Dani-Ald/RB-DANI-/Materiales/RB2026.pdf

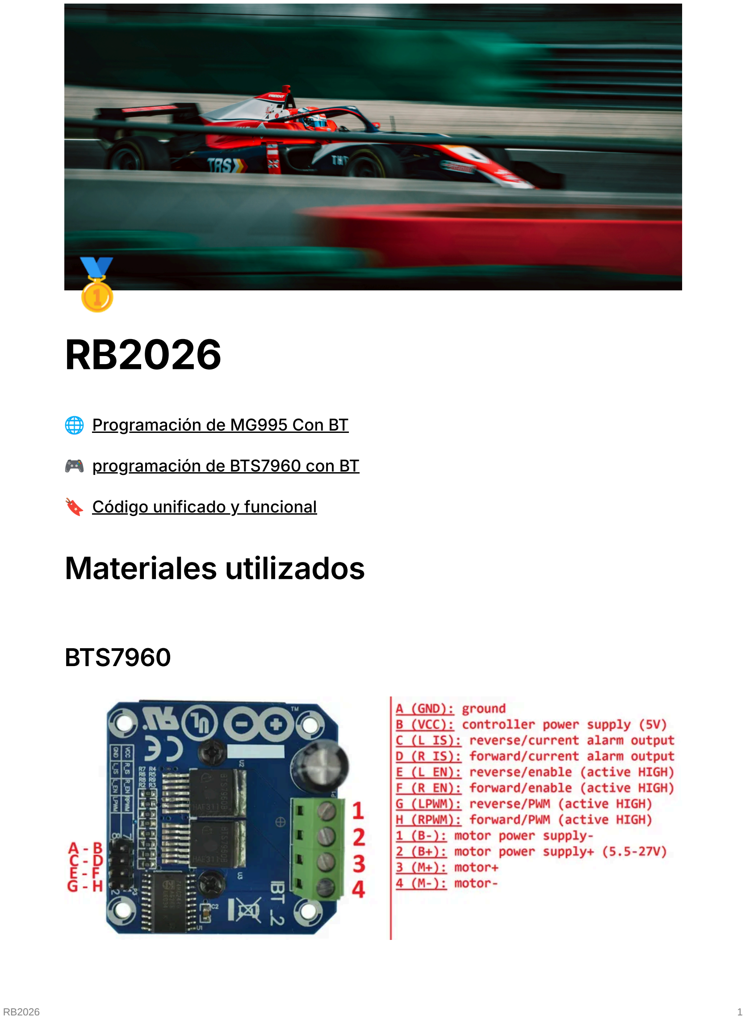
[picture p3: page 1]

🥇
RB2026

🌐 Programación de MG995 Con BT (https://app.notion.com/p/Programaci-n-de-MG995-Con-BT-315e5d4cf5a5803289f7de62a6ee55a4?pvs=21)

🎮 programación de BTS7960 con BT (https://app.notion.com/p/programaci-n-de-BTS7960-con-BT-315e5d4cf5a58018bc2edbbad9db19d2?pvs=21)

🔖 Código unificado y funcional (https://app.notion.com/p/C-digo-unificado-y-funcional-315e5d4cf5a580a5864ffad67fe94708?pvs=21)

# Materiales utilizados

## BTS7960

RB2026 | 1

## RS550 de 6V

## ESP 32

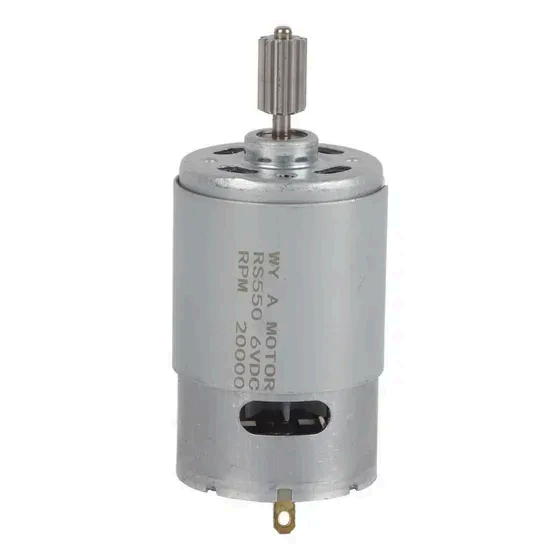
[picture p4: figure]

Durante el desarrollo de este proyecto, se utilizaron diferentes modelos de ESP

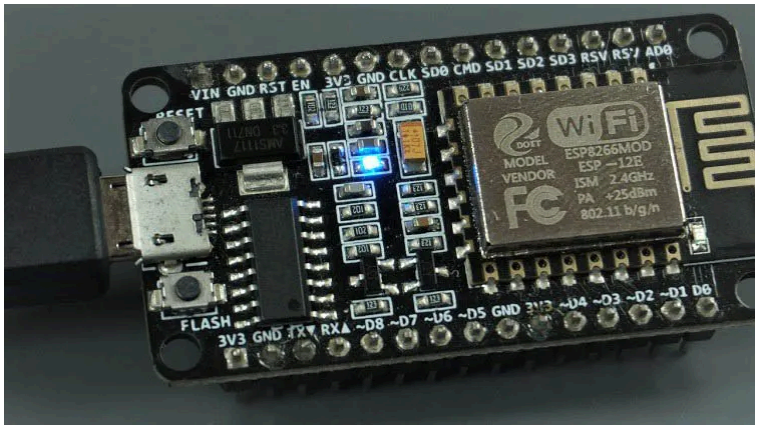
[picture p5: figure]

## Pack de 3 baterias 18650 3.7v 2000mah

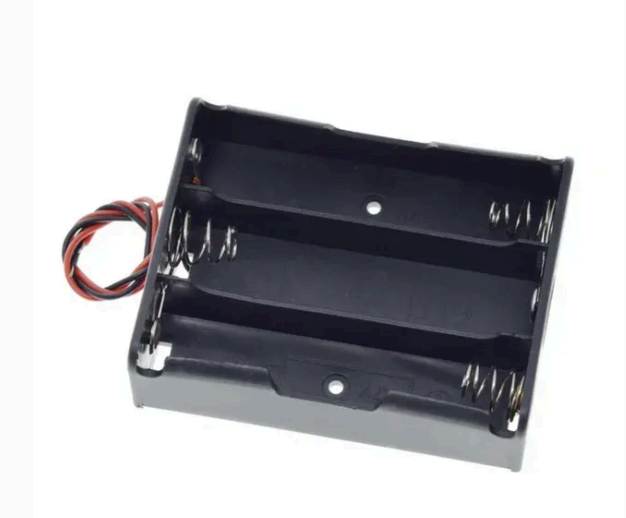
[picture p6: figure]

## Servomotor MG995

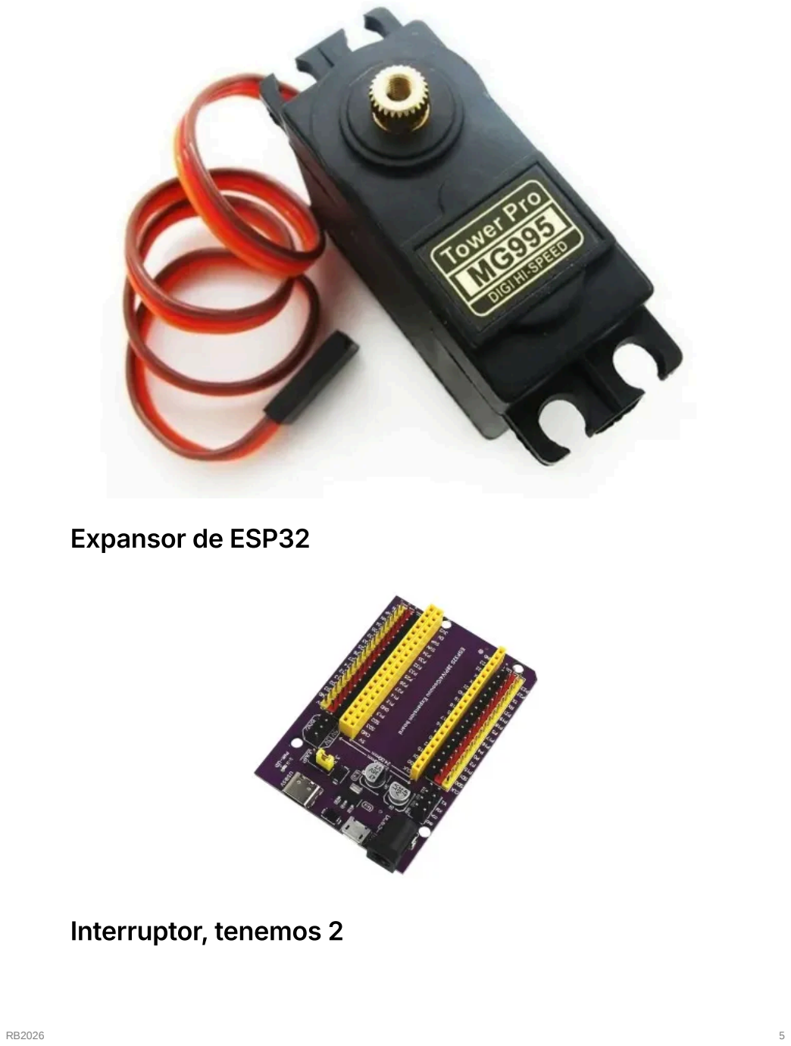
[picture p7: page 5]

## Expansor de ESP32

## Interruptor, tenemos 2

## Conector DC

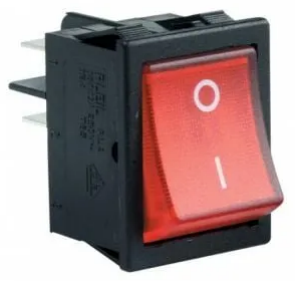
[picture p8: figure]

Cable para conectar el pack de baterías con el modulo de expansión, este se conecta al puerto dc 6.5 a 16v se usara para alimentar a la esp para hacerlo mas facil

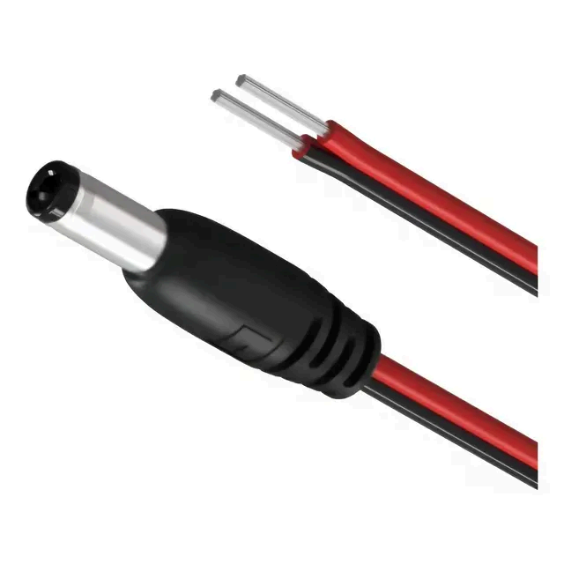
[picture p9: figure]

## Tarjeta de expacion

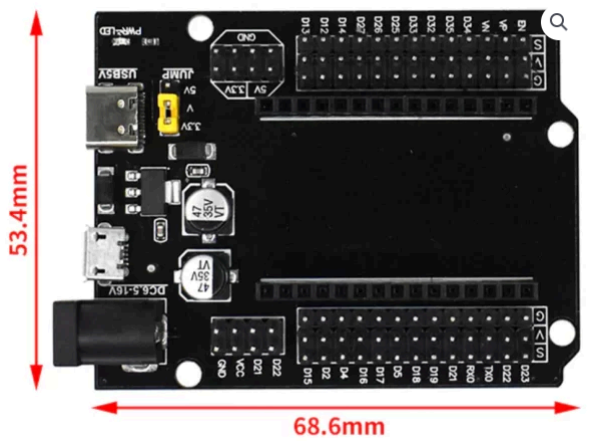
[picture p10: figure]

## BATERIA 460mAh, 35 cell, 11.1v

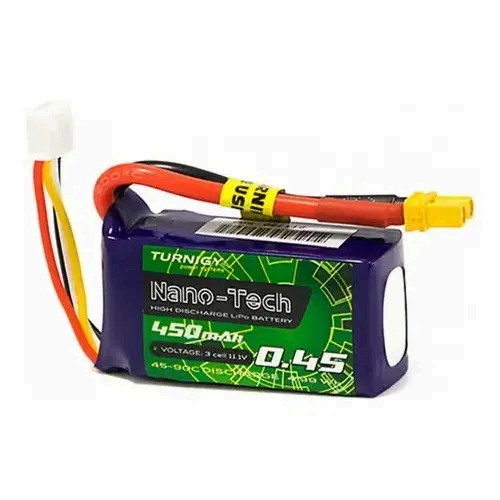
[picture p11: figure]

LM2596

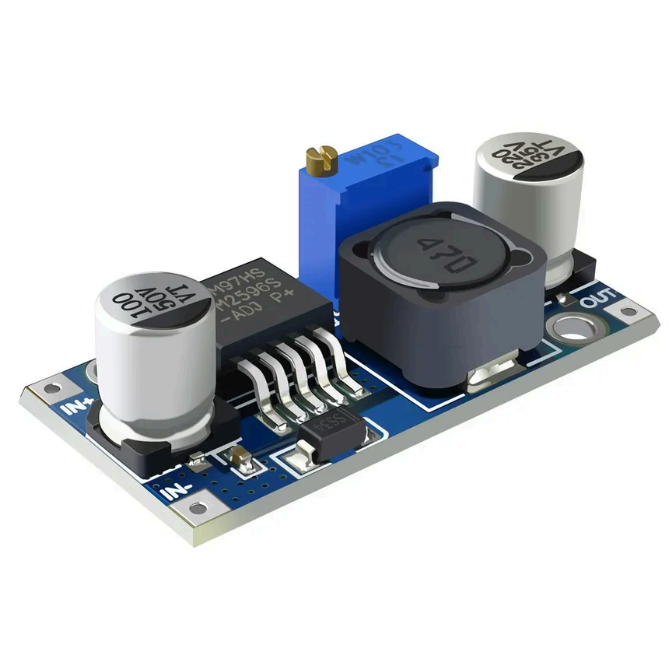
[picture p12: figure]
